westonb/open-cell-incubator/schematics/host_board.pdf

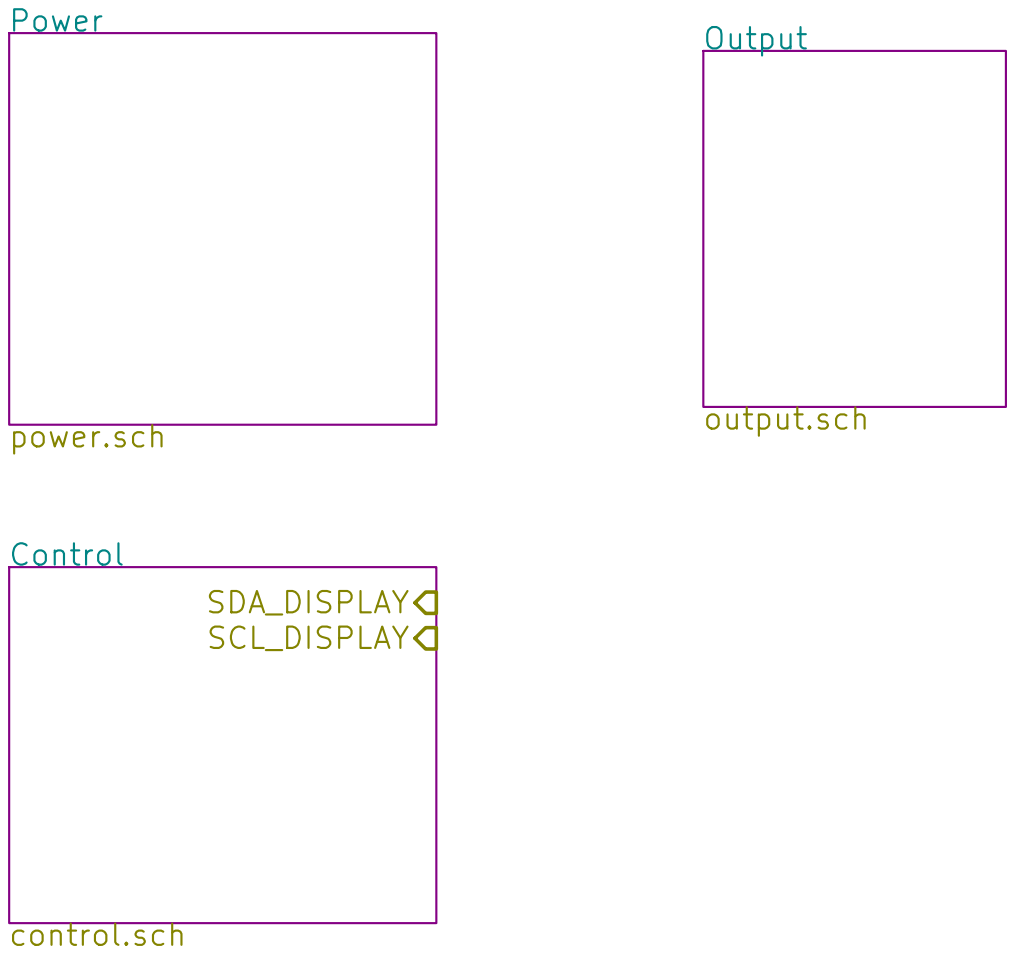
[picture p1: page 1]

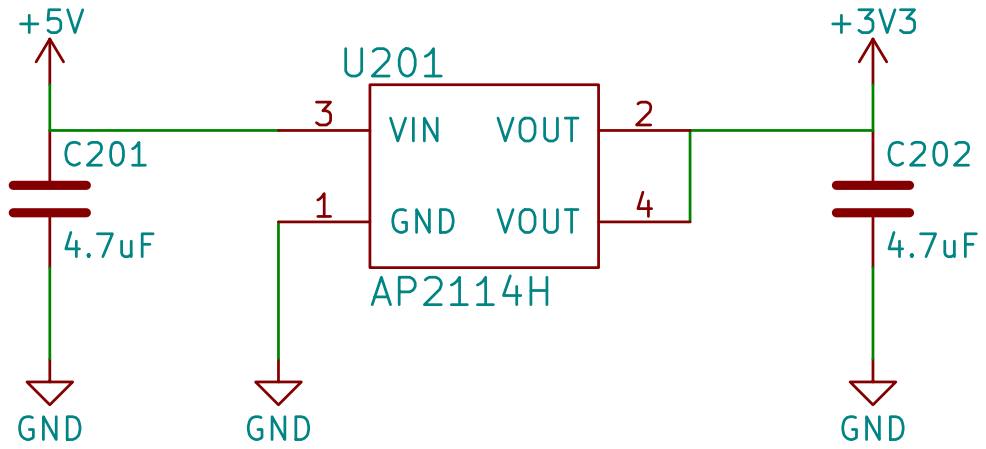
[picture p2: page 2]

File: power.sch Sheet: /Power/ C202

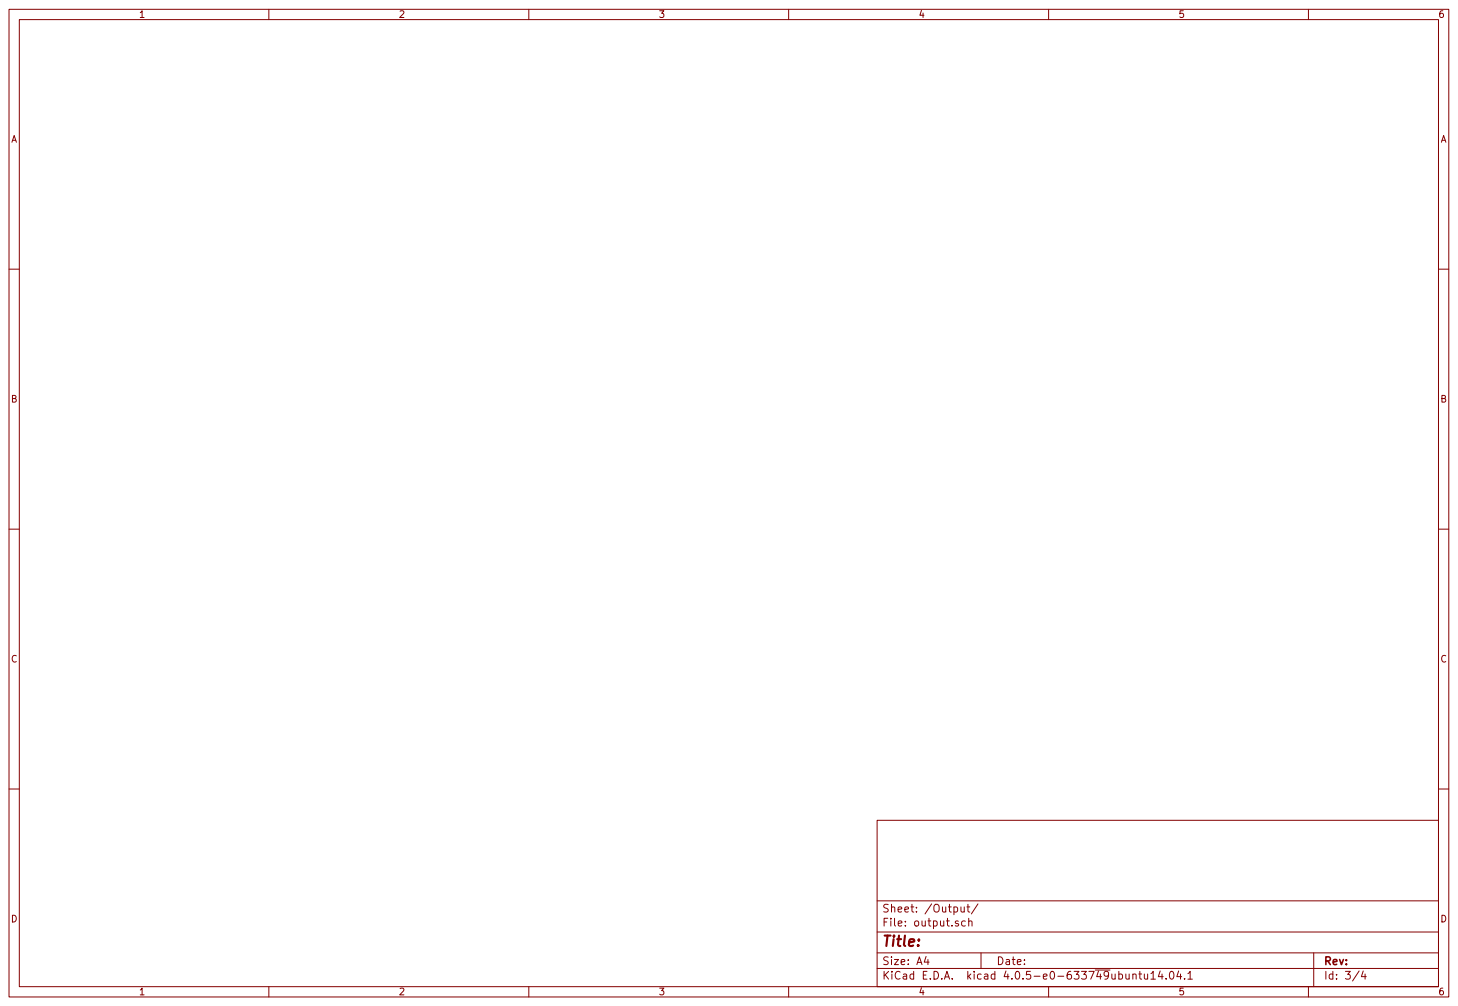
[picture p3: page 3]

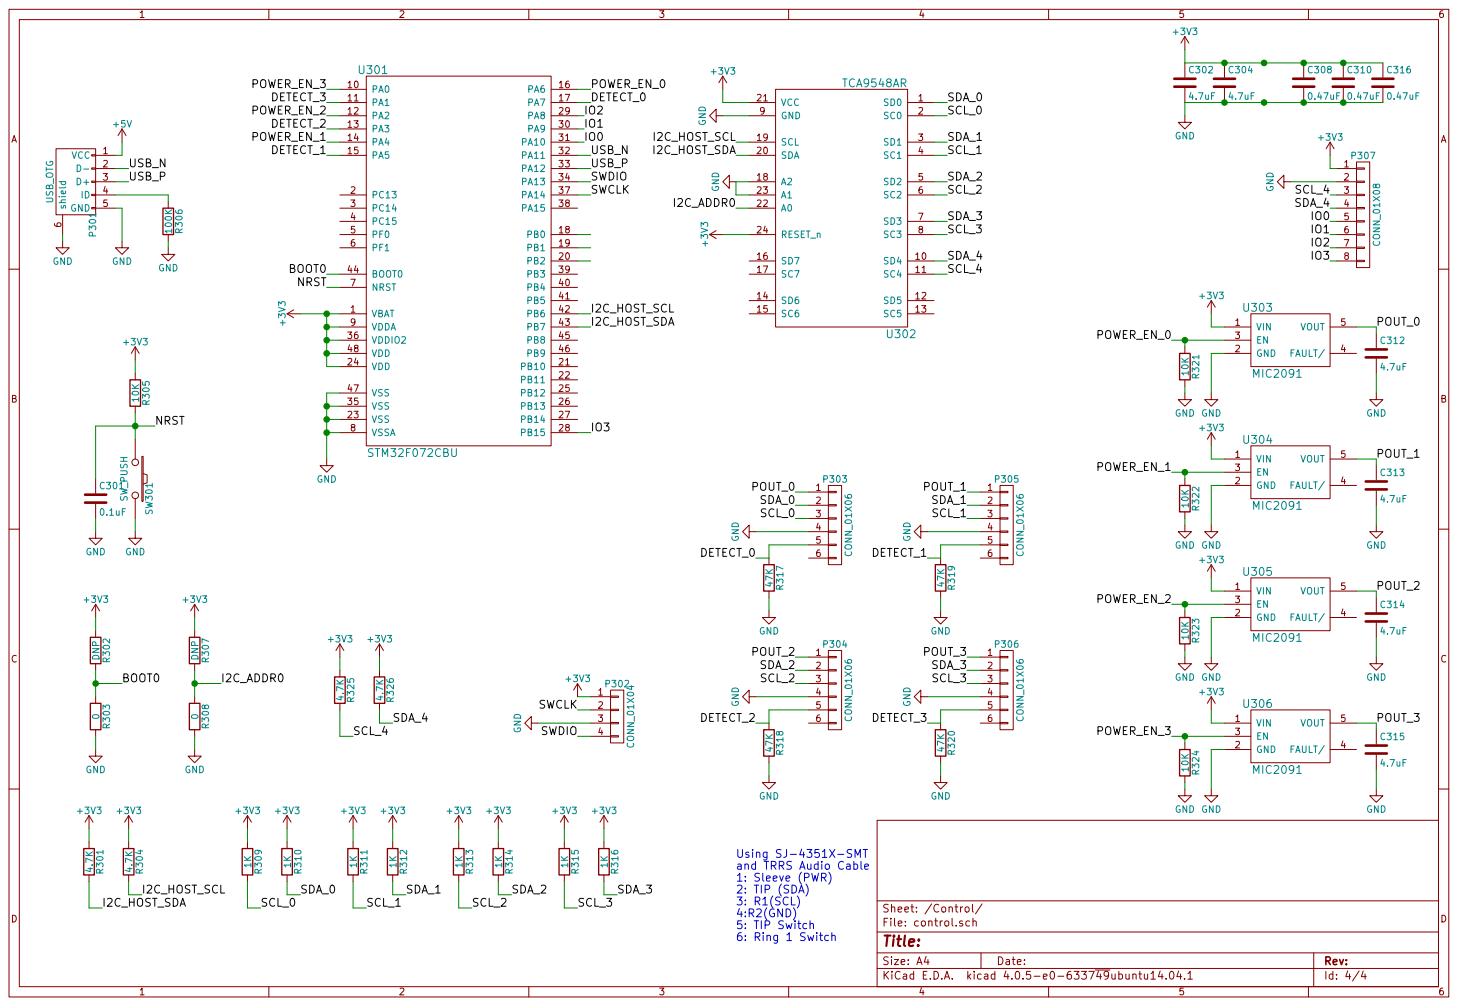
[picture p4: page 4]

+3V3 GND +3V3 GND DNP R307 R308 0 +3V3 GND

Using SJ-4351X-SMT
and TRRS Audio Cable
1: Sleeve (PWR)
2: TIP (SDA)
3: R1(SCL)
4:R2(GND)
5: TIP Switch
6: Ring 1 Switch

Id: 4/4 Title: File: control.sch Sheet: /Control/
