westonb/open-cell-incubator/pcb/host_board/host_board.kicad_pcb

## KiCad design pcb/host_board/host_board.kicad_pcb (2016-02-26)

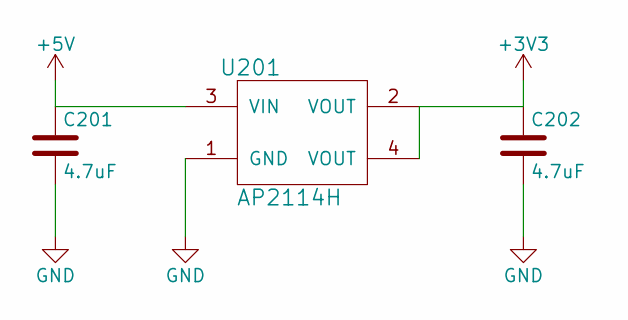
[picture p5: schematic power.sch]

Parts:
C201, C202: 4.7uF; C_0603
U201: AP2114H; SOT-223

Connections:
+3V3: C202.1, U201.2 (VOUT), U201.4 (VOUT); also elsewhere on the board
+5V: C201.1, U201.3 (VIN); also elsewhere on the board
GND: C201.2, C202.2, U201.1 (GND); also elsewhere on the board

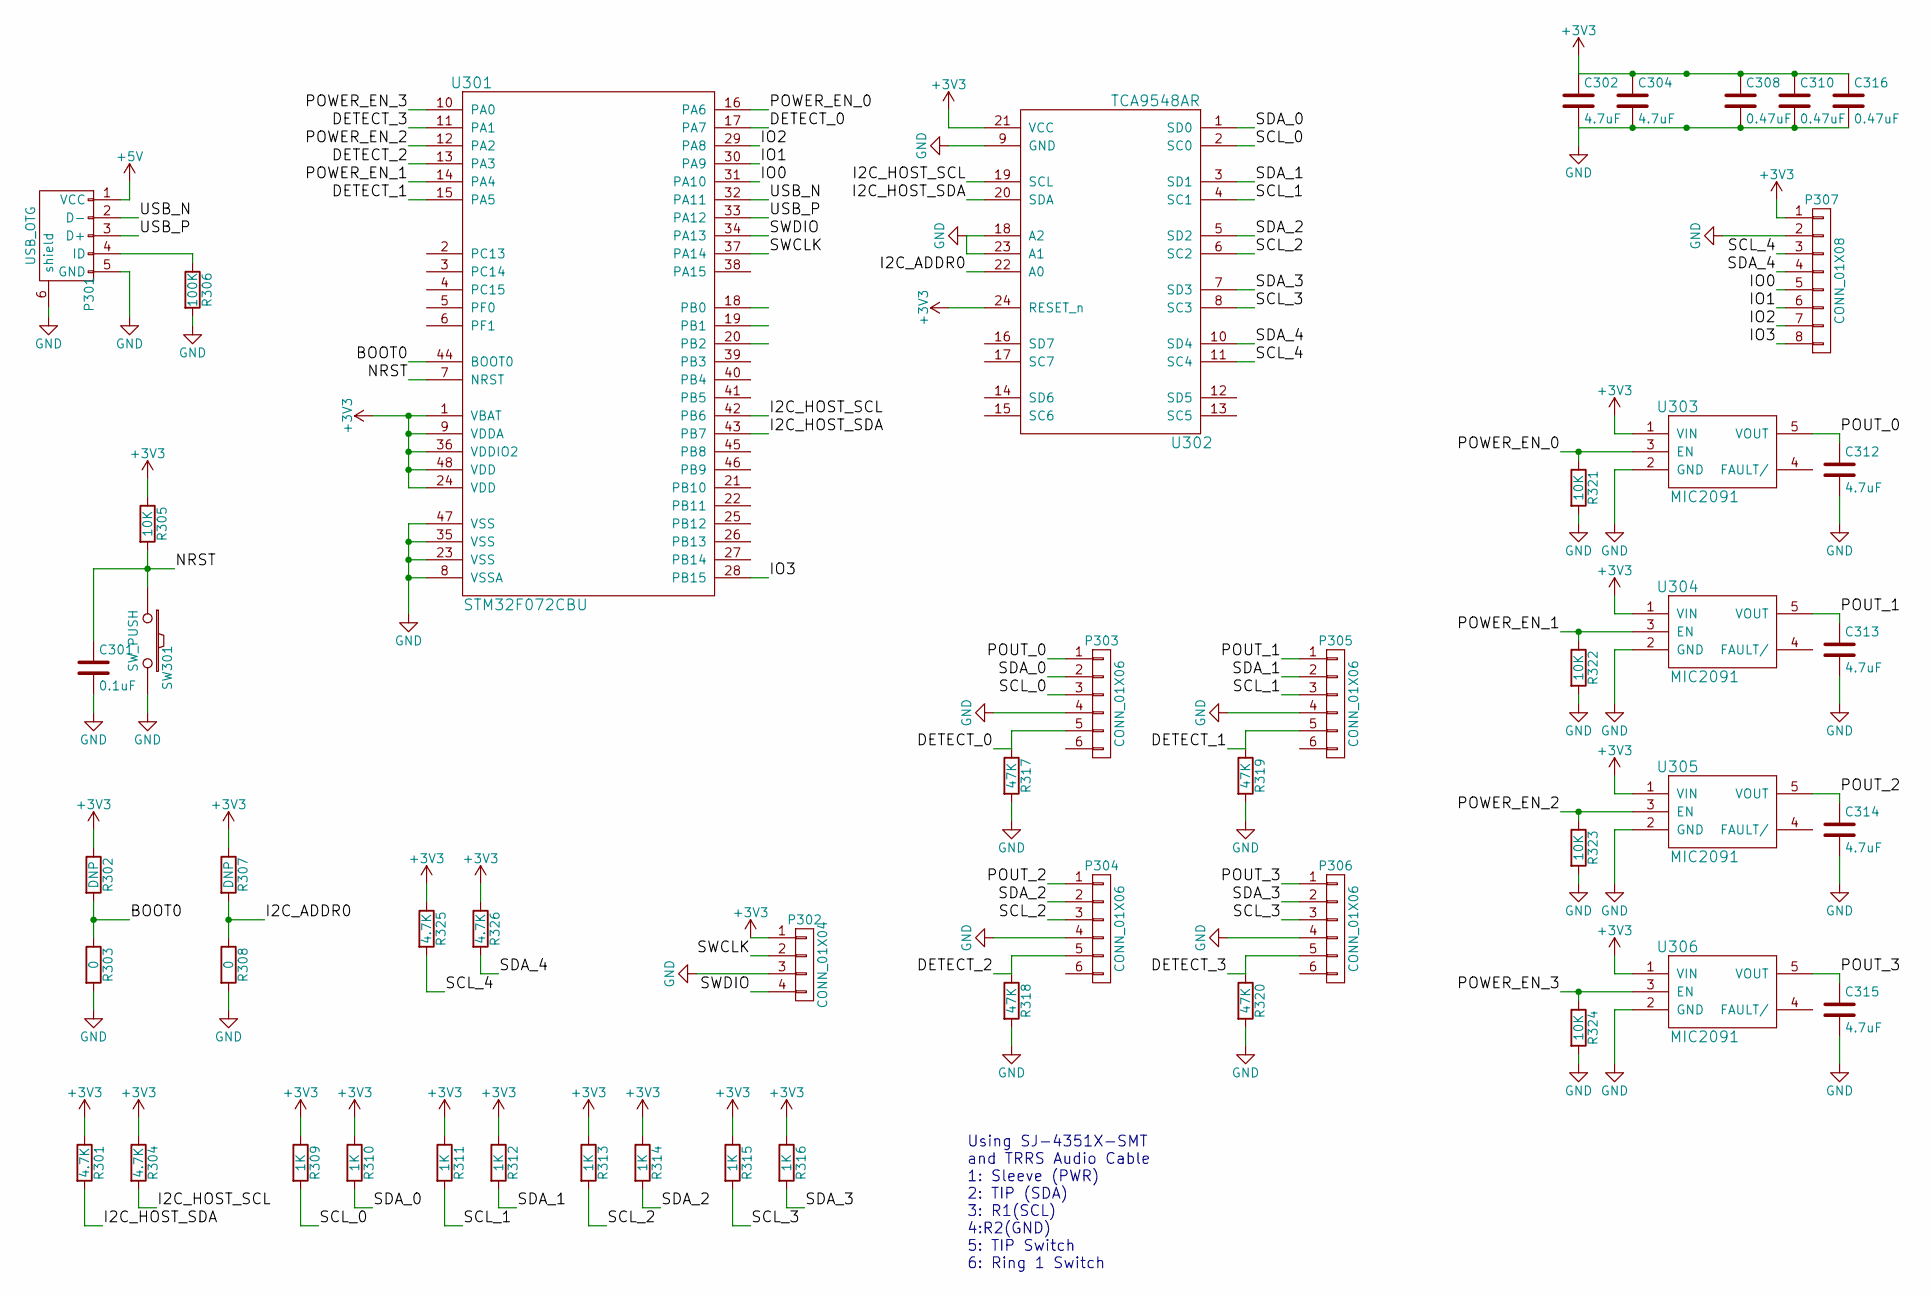
[picture p6: schematic control.sch]

Parts:
C301: 0.1uF; C_0603
C302, C304, C312, C313, C314, C315: 4.7uF; C_0603
C308, C310, C316: 0.47uF; C_0603
P301: USB_OTG; USB_Micro-B_10103594-0001LF
P302: CONN_01X04; Pin_Header_Straight_1x04
P303, P304, P305, P306: CONN_01X06; SJ-4351_X-SMT
P307: CONN_01X08; Pin_Header_Straight_1x08
R301, R304, R325, R326: 4.7K; R_0603
R302, R307: DNP; R_0603
R303, R308: 0; R_0603
R305, R321, R322, R323, R324: 10K; R_0603
R306: 100K; R_0603
R309, R310, R311, R312, R313, R314, R315, R316: 1K; R_0603
R317, R318, R319, R320: 47K; R_0603
SW301: SW_PUSH; button-5mm
U301: STM32F072CBU; QFN-48-1EP_7x7mm_Pitch0.5mm
U302: TCA9548AR; QFN-24-1EP_4x4mm_Pitch0.5mm
U303, U304, U305, U306: MIC2091; SOT-23-5

Connections:
+3V3: C302.1, C304.1, C308.1, C310.1, C316.1, P302.1, P307.1, R301.1, R302.1, R304.1, R305.1, R307.1, R309.1, R310.1, R311.1, R312.1, R313.1, R314.1, R315.1, R316.1, R325.1, R326.1, U301.1 (VBAT), U301.9 (VDDA), U301.24 (VDD), U301.36 (VDDIO2), U301.48 (VDD), U302.21 (VCC), U302.24 (RESET_n), U303.1 (VIN), U304.1 (VIN), U305.1 (VIN), U306.1 (VIN); also elsewhere on the board
+5V: P301.1 (VCC); also elsewhere on the board
/Control/BOOT0: R302.2, R303.1, U301.44 (BOOT0)
/Control/DETECT_0: P303.5, R317.1, U301.17 (PA7)
/Control/DETECT_1: P305.5, R319.1, U301.15 (PA5)
/Control/DETECT_2: P304.5, R318.1, U301.13 (PA3)
/Control/DETECT_3: P306.5, R320.1, U301.11 (PA1)
/Control/I2C_ADDR0: R307.2, R308.1, U302.22 (A0)
/Control/I2C_HOST_SCL: R304.2, U301.42 (PB6), U302.19 (SCL)
/Control/I2C_HOST_SDA: R301.2, U301.43 (PB7), U302.20 (SDA)
/Control/IO0: P307.5, U301.31 (PA10)
/Control/IO1: P307.6, U301.30 (PA9)
/Control/IO2: P307.7, U301.29 (PA8)
/Control/IO3: P307.8, U301.28 (PB15)
/Control/NRST: C301.1, R305.2, SW301.1, U301.7 (NRST)
/Control/POUT_0: C312.1, P303.1, U303.5 (VOUT)
/Control/POUT_1: C313.1, P305.1, U304.5 (VOUT)
/Control/POUT_2: C314.1, P304.1, U305.5 (VOUT)
/Control/POUT_3: C315.1, P306.1, U306.5 (VOUT)
/Control/POWER_EN_0: R321.1, U301.16 (PA6), U303.3 (EN)
/Control/POWER_EN_1: R322.1, U301.14 (PA4), U304.3 (EN)
/Control/POWER_EN_2: R323.1, U301.12 (PA2), U305.3 (EN)
/Control/POWER_EN_3: R324.1, U301.10 (PA0), U306.3 (EN)
/Control/SCL_0: P303.3, R309.2, U302.2 (SC0)
/Control/SCL_1: P305.3, R311.2, U302.4 (SC1)
/Control/SCL_2: P304.3, R313.2, U302.6 (SC2)
/Control/SCL_3: P306.3, R315.2, U302.8 (SC3)
/Control/SCL_4: P307.3, R325.2, U302.11 (SC4)
/Control/SDA_0: P303.2, R310.2, U302.1 (SD0)
/Control/SDA_1: P305.2, R312.2, U302.3 (SD1)
/Control/SDA_2: P304.2, R314.2, U302.5 (SD2)
/Control/SDA_3: P306.2, R316.2, U302.7 (SD3)
/Control/SDA_4: P307.4, R326.2, U302.10 (SD4)
/Control/SWCLK: P302.2, U301.37 (PA14)
/Control/SWDIO: P302.4, U301.34 (PA13)
/Control/USB_N: P301.2 (D-), U301.32 (PA11)
/Control/USB_P: P301.3 (D+), U301.33 (PA12)
GND: C301.2, C302.2, C304.2, C308.2, C310.2, C312.2, C313.2, C314.2, C315.2, C316.2, P301.5 (GND), P301.6 (shield), P302.3, P303.4, P304.4, P305.4, P306.4, P307.2, R303.2, R306.2, R308.2, R317.2, R318.2, R319.2, R320.2, R321.2, R322.2, R323.2, R324.2, SW301.2, U301.8 (VSSA), U301.23 (VSS), U301.35 (VSS), U301.47 (VSS), U302.9 (GND), U302.18 (A2), U302.23 (A1), U303.2 (GND), U304.2 (GND), U305.2 (GND), U306.2 (GND); also elsewhere on the board
unnamed: P301.4 (ID), R306.1

Notes on the sheet:
Using SJ-4351X-SMT and TRRS Audio Cable 1: Sleeve (PWR) 2: TIP (SDA) 3: R1(SCL) 4:R2(GND) 5: TIP Switch 6: Ring 1 Switch

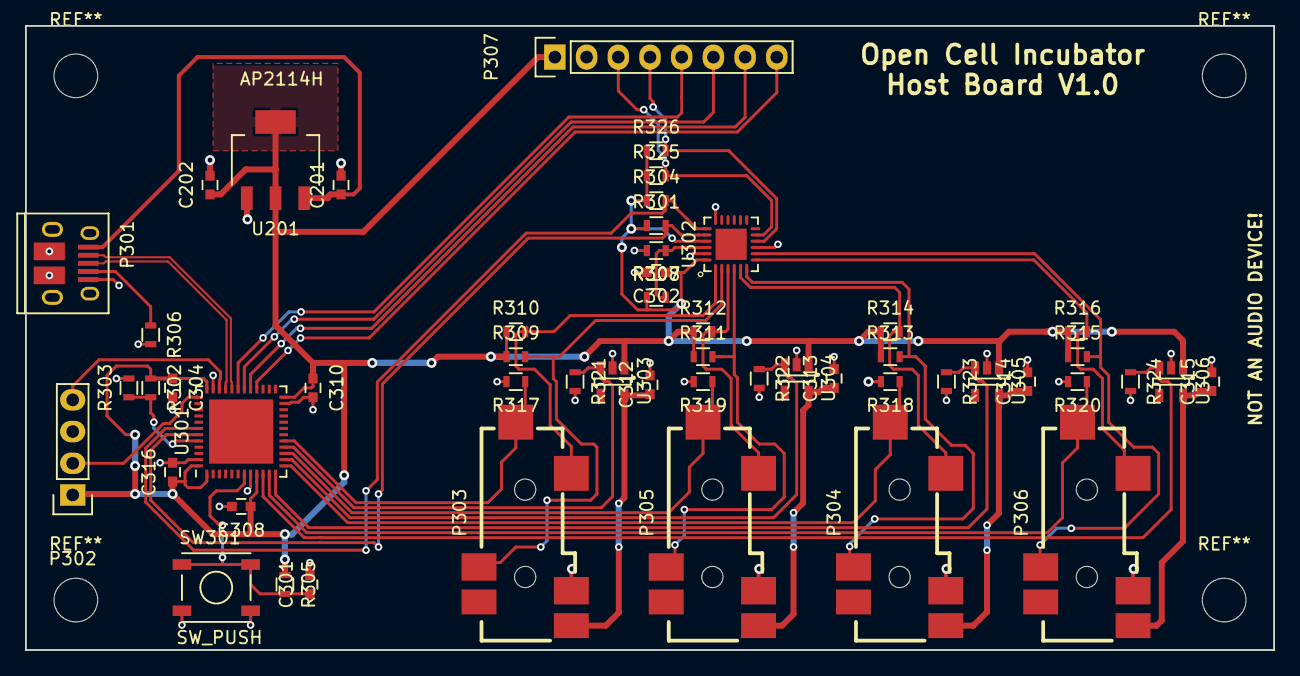
[picture p7: board host_board.kicad_pcb from above]

Board: 2 copper layers, 100.0 x 50.0 mm, 53 parts (0 on the bottom side), 39 nets.
