westonb/open-cell-incubator/pcb/sensor_board/flask_sensor.kicad_pcb

## KiCad design pcb/sensor_board/flask_sensor.kicad_pcb (2016-02-03)

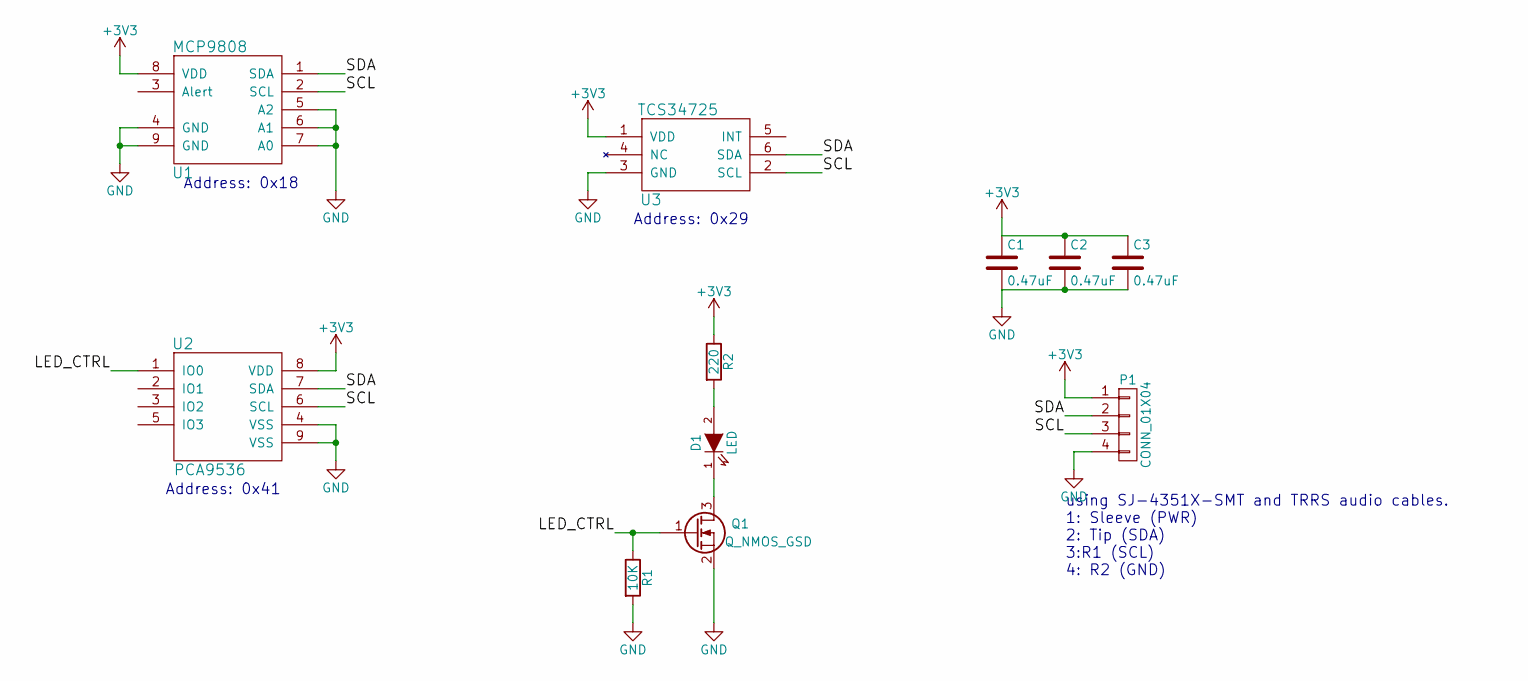
[picture p8: schematic flask_sensor.sch]

Parts:
C1, C2, C3: 0.47uF; C_0603
D1: LED; LM561B-LED
P1: CONN_01X04; SJ-4351_X-SMT
Q1: Q_NMOS_GSD; SOT-23
R1: 10K; R_0603
R2: 220; R_0805
U1: MCP9808; DFN-8-1EP_3x2mm_Pitch0.5mm
U2: PCA9536; DFN-8-1EP_3x3mm_Pitch0.5mm
U3: TCS34725; FN-6(TCS3472x)

Connections:
+3V3: C1.1, C2.1, C3.1, P1.1, R2.1, U1.8 (VDD), U2.8 (VDD), U3.1 (VDD)
/LED_CTRL: Q1.1 (G), R1.1, U2.1 (IO0)
/SCL: P1.3, U1.2 (SCL), U2.6 (SCL), U3.2 (SCL)
/SDA: P1.2, U1.1 (SDA), U2.7 (SDA), U3.6 (SDA)
GND: C1.2, C2.2, C3.2, P1.4, Q1.2 (S), R1.2, U1.4 (GND), U1.5 (A2), U1.6 (A1), U1.7 (A0), U1.9 (GND), U2.4 (VSS), U2.9 (VSS), U3.3 (GND)
unnamed: D1.1 (K), Q1.3 (D)
unnamed: D1.2 (A), R2.2

Notes on the sheet:
Address: 0x41
Address: 0x29
Address: 0x18
using SJ-4351X-SMT and TRRS audio cables. 1: Sleeve (PWR) 2: Tip (SDA) 3:R1 (SCL) 4: R2 (GND)

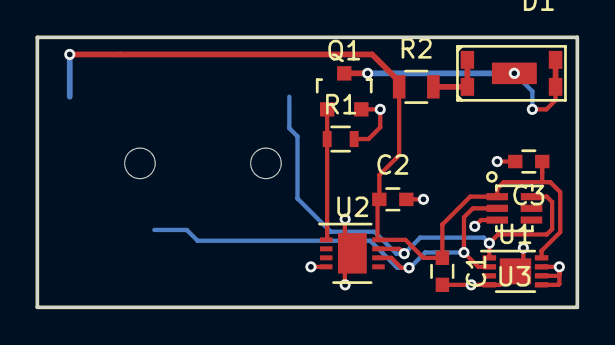
[picture p9: board flask_sensor.kicad_pcb from above]

Board: 2 copper layers, 30.0 x 15.0 mm, 11 parts (1 on the bottom side), 7 nets.
