westonb/open-cell-incubator/firmware/host_board/STMCUBE/host_firmware.ioc

Mcu.UserName=STM32F072CBUx
PA0.Signal=GPIO_Output
PA1.Signal=GPIO_Input
PA11.Signal=USB_DM
PA12.Signal=USB_DP
PA2.Signal=GPIO_Output
PA3.Signal=GPIO_Input
PA4.Signal=GPIO_Output
PA5.Signal=GPIO_Input
PA6.Signal=GPIO_Output
PA7.Signal=GPIO_Input
PB6.Signal=I2C1_SCL
PB7.Signal=I2C1_SDA
