westonb/open-cell-incubator/(commit log)

2016-02-26 designed host board
    [Display.sch, control.sch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]
2016-04-03 setup toolchain
    [board_openocd.cfg]
2016-04-25 fixed linker file, got basic data logging over USB working
    [main.c]
2017-02-19 added pdb schematic
    [control.sch, host_board.sch, output.sch, power.sch]
